abel-msk/RasberryPI-debug-ESP-HAT/BOM.csv

Обозначения | Номинал | Корпус | Кол-во | DNP | Описание
C1,C3 | 100n | Capacitor_SMD:C_0805_2012Metric_Pad1.18x1.45mm_HandSolder | 2 |  | Unpolarized capacitor, small symbol
C2 | 10u | Capacitor_SMD:C_0805_2012Metric_Pad1.18x1.45mm_HandSolder | 1
D1 | GREEN | LED_SMD:LED_0603_1608Metric_Pad1.05x0.95mm_HandSolder | 1 |  | LED 0603 green, ESP power indicator
D2-D11 | BLUE | LED_SMD:LED_0603_1608Metric | 10 |  | LED 0603 blue TO-1608BC-BF, GPIO activity
J1 | GPIO | Connector_PinSocket_2.54mm:PinSocket_2x20_P2.54mm_Vertical | 1 |  | Generic connector, double row, 02x20, odd/even pin numbering scheme (row 1 odd numbers, row 2 even numbers), script generated (kicad-library-utils/schlib/autogen/connector/)
J2,J3 | KF250-2.54-8P | TerminalBlock_Local:KF250-2.54-8P | 2 |  | Spring terminal block KF250-2.54-8P-1 (LCSC C49173293), ESP left row: IO5..IO10, IO20, IO21 (pin 8 = IO21),Spring terminal block KF250-2.54-8P-1 (LCSC C49173293), ESP right row: IO0..IO4, 3V3, GND, ESP 5V (pin 8)
J4,J5 | PinSocket_1x08_P2.54mm | Connector_PinSocket_2.54mm:PinSocket_1x08_P2.54mm_Vertical | 2 |  | Female pin header 1x8, 2.54 mm, vertical, socket for U2 ESP32-C3 SuperMini; BOM only, part of U2 footprint
JP1 | ID_WP | Connector_PinHeader_2.54mm:PinHeader_1x02_P2.54mm_Vertical | 1 |  | Jumper, 2-pole, open (2-pin header)
Q1 | AO3401A | Package_TO_SOT_SMD:SOT-23 | 1
R1,R2 | 3.9k | Resistor_SMD:R_0805_2012Metric_Pad1.20x1.40mm_HandSolder | 2 |  | Resistor, small symbol
R3-R15,R17,R18 | 1k | Resistor_SMD:R_0805_2012Metric_Pad1.20x1.40mm_HandSolder | 15
R16 | 100k | Resistor_SMD:R_0805_2012Metric_Pad1.20x1.40mm_HandSolder | 1
R19-R28 | 1k | Resistor_SMD:R_0603_1608Metric | 10 |  | LED current limit, 0603
SW1 | RESET (power cycle) | SW_SPST_Omron_B3FS-100xP | 1
SW2 | BOOT | SW_SPST_Omron_B3FS-100xP | 1
U1 | CAT24C256 | Package_SO:SOIC-8_3.9x4.9mm_P1.27mm | 1 |  | 256 kb CMOS Serial EEPROM, DIP-8/SOIC-8/TSSOP-8/DFN-8
U2 | ESP32-C3 Pro Mini | ESP_Debug:ESP32-C3_Pro_mini_socket | 1
