abel-msk/RasberryPI-debug-ESP-HAT/schematic.pdf

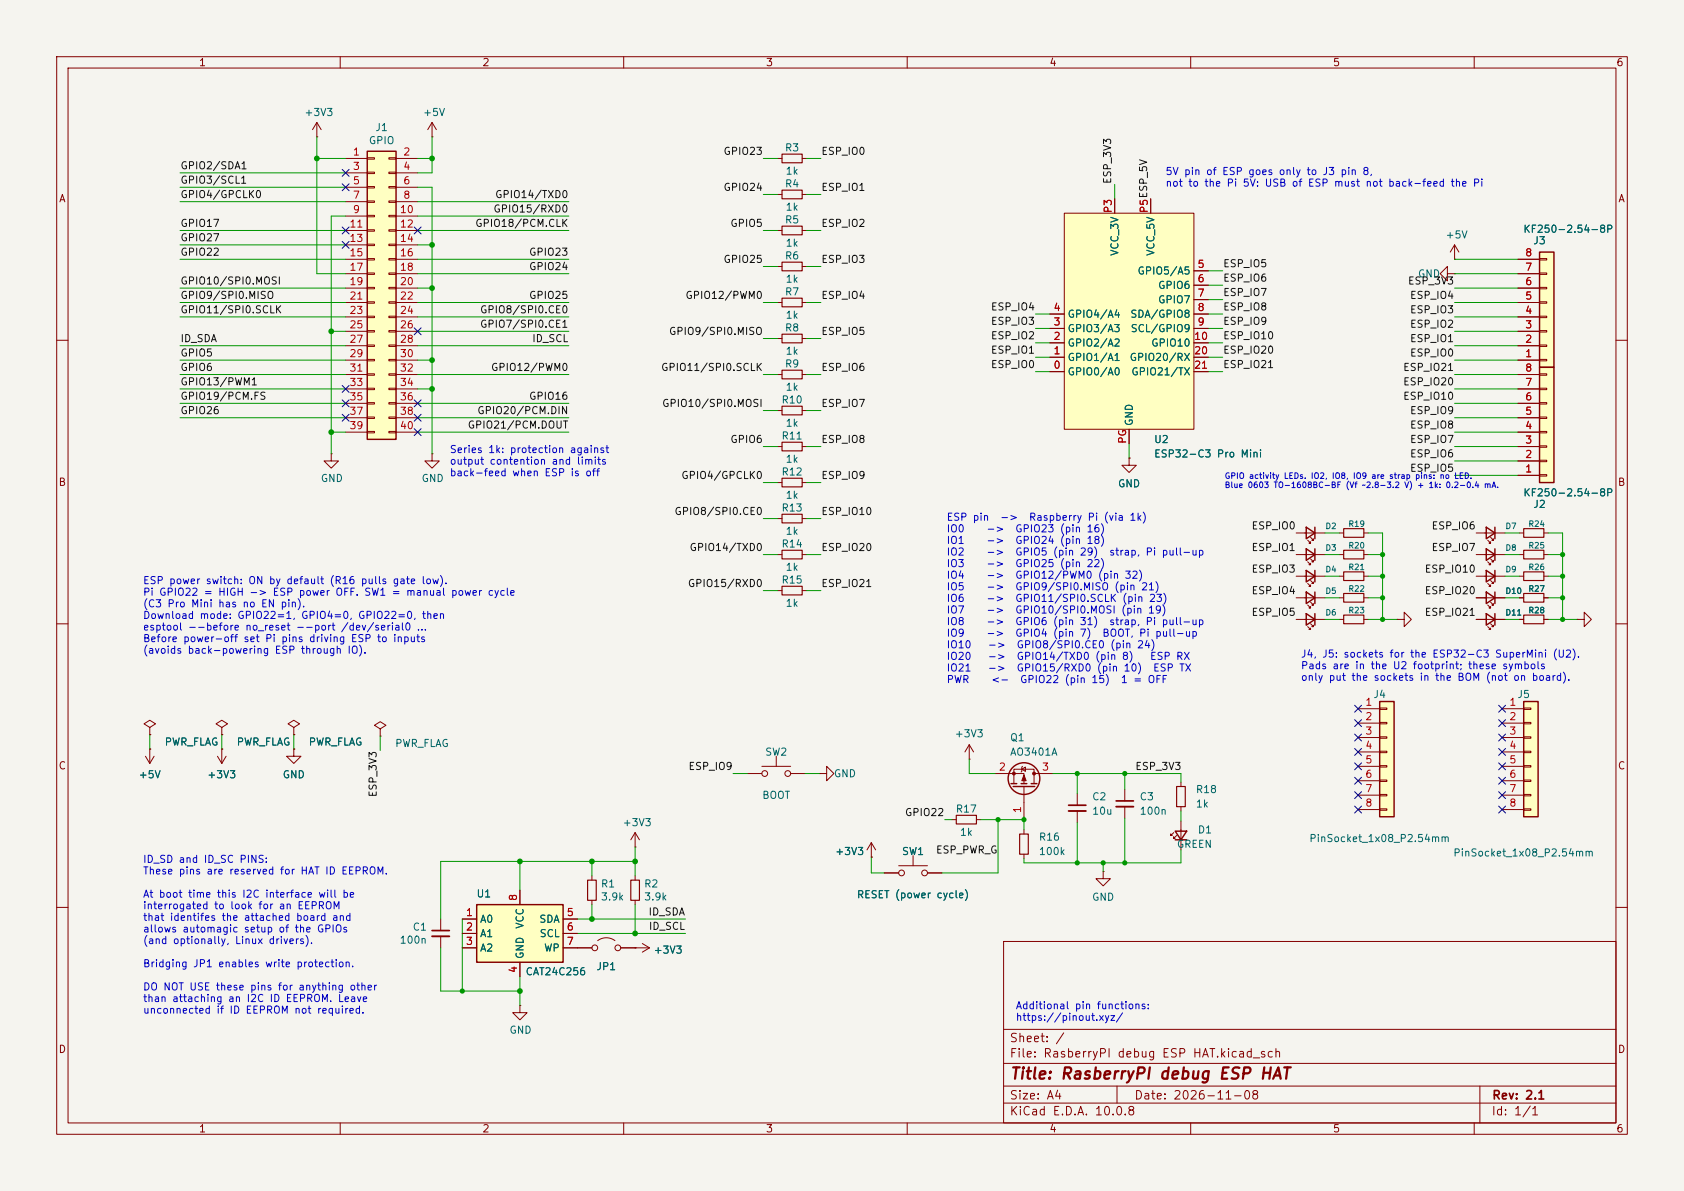
[picture p3: page 1]

GPIO activity LEDs. IO2, IO8, IO9 are strap pins: no LED. Blue 0603 TO-1608BC-BF (Vf ~2.8-3.2 V) + 1k: 0.2-0.4 mA. ESP power switch: ON by default (R16 pulls gate low). Pi GPIO22 = HIGH -> ESP power OFF. SW1 = manual power cycle

ESP pin -> Raspberry Pi (via 1k)

(C3 Pro Mini has no EN pin). Download mode: GPIO22=1, GPIO4=0, GPIO22=0, then

esptool --before no_reset --port /dev/serial0 ... Before power-off set Pi pins driving ESP to inputs

(avoids back-powering ESP through IO).

only put the sockets in the BOM (not on board). Additional pin functions: https://pinout.xyz/

ID_SD and ID_SC PINS: These pins are reserved for HAT ID EEPROM. At boot time this I2C interface will be

interrogated to look for an EEPROM
that identifes the attached board and
allows automagic setup of the GPIOs
(and optionally, Linux drivers).

Bridging JP1 enables write protection. DO NOT USE these pins for anything other

than attaching an I2C ID EEPROM. Leave unconnected if ID EEPROM not required.

Sheet: /
File: RasberryPI debug ESP HAT.kicad_sch
Title: RasberryPI debug ESP HAT

Size: A4 | Rev: 2.1
KiCad E.D.A. 10.0.8 | Id: 1/1
