abel-msk/RasberryPI-debug-ESP-HAT/RasberryPI debug ESP HAT.kicad_pcb

## KiCad design RasberryPI debug ESP HAT.kicad_pcb (2026-11-08)

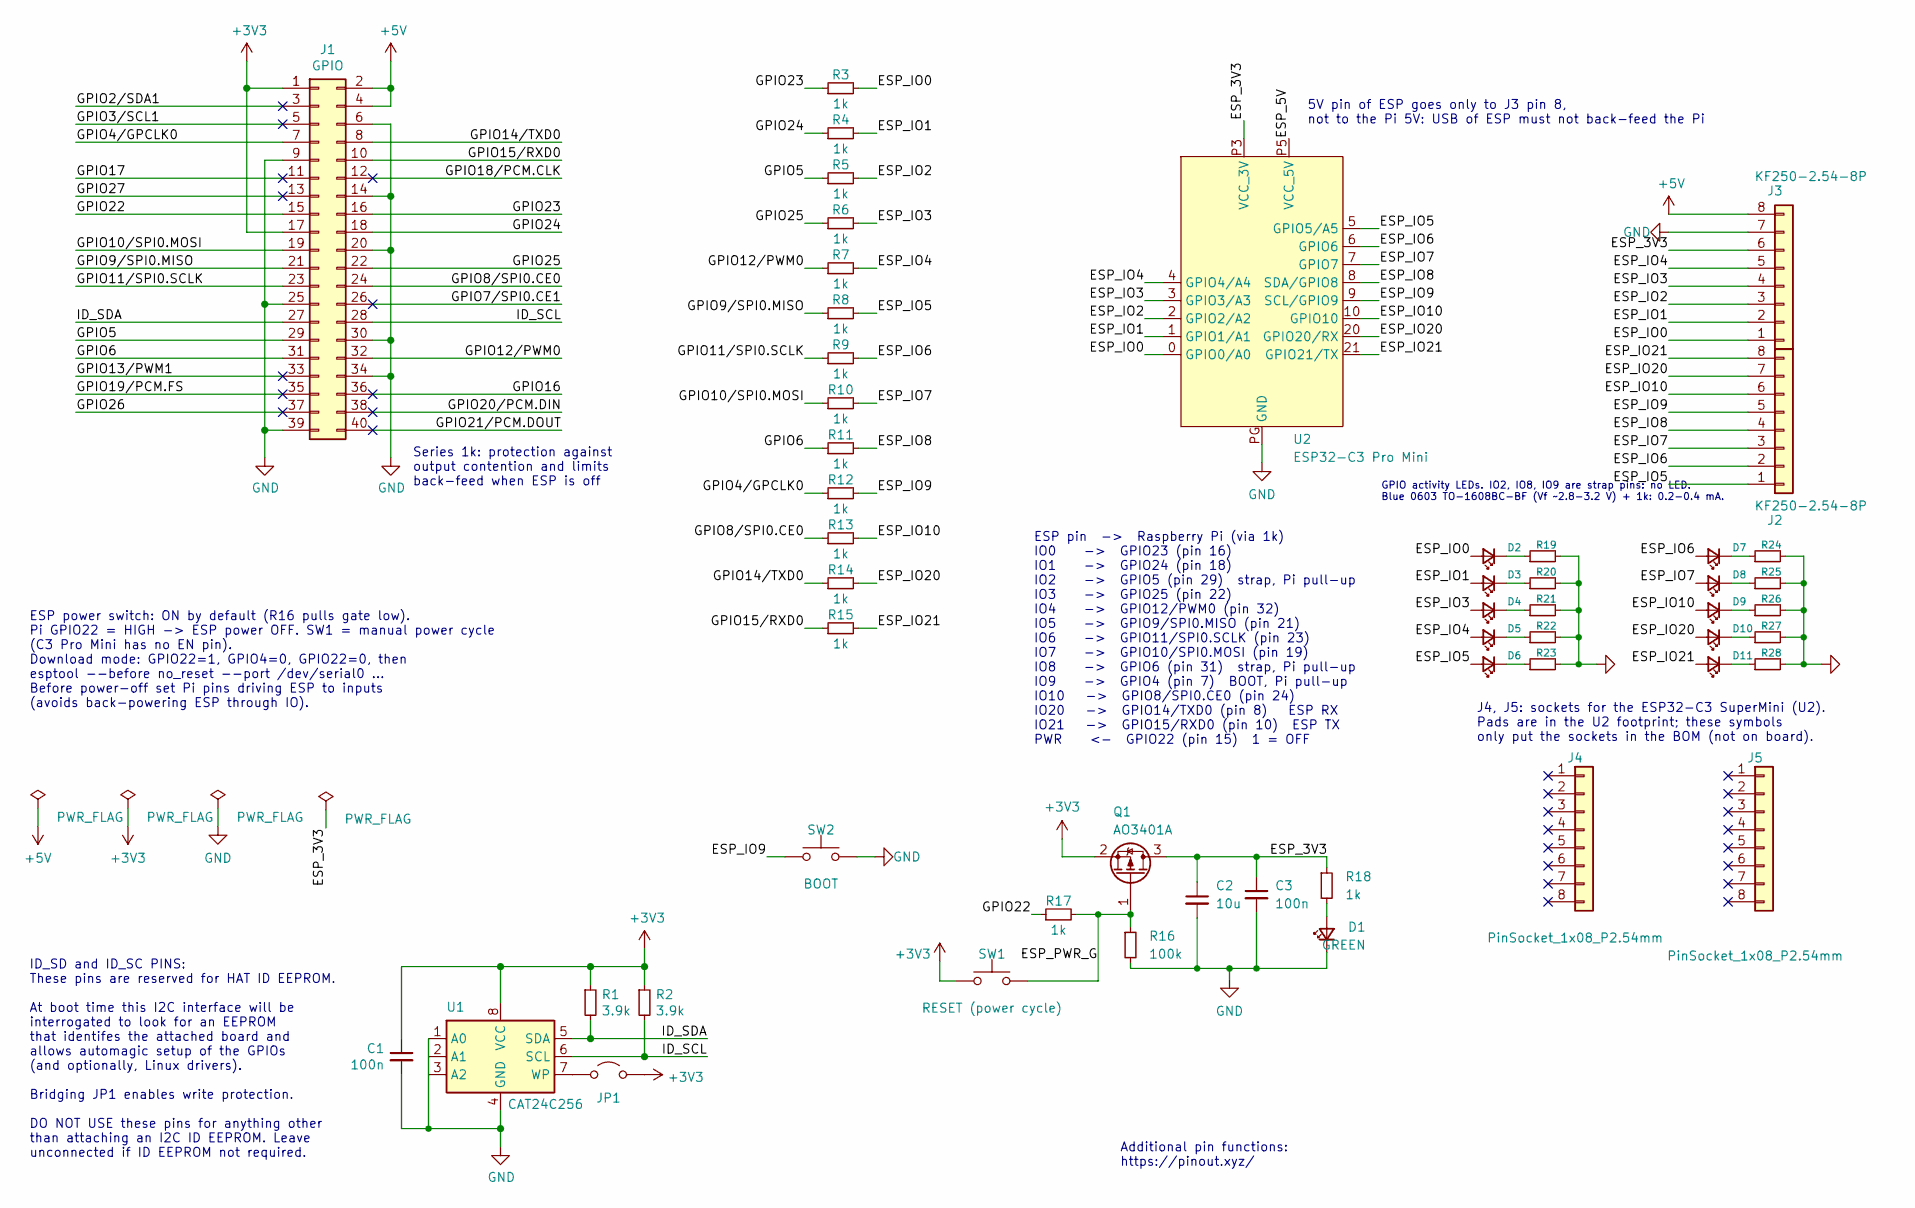
[picture p4: schematic RasberryPI debug ESP HAT.kicad_sch]

Parts:
C1, C3: 100n; C_0805_2012Metric_Pad1.18x1.45mm_HandSolder
C2: 10u; C_0805_2012Metric_Pad1.18x1.45mm_HandSolder
D1: GREEN; LED_0603_1608Metric_Pad1.05x0.95mm_HandSolder
D2, D3, D4, D5, D6, D7, D8, D9, D10, D11: BLUE; LED_0603_1608Metric
J1: GPIO; PinSocket_2x20_P2.54mm_Vertical
J2, J3: KF250-2.54-8P
J4, J5: PinSocket_1x08_P2.54mm; PinSocket_1x08_P2.54mm_Vertical
JP1: ID_WP; PinHeader_1x02_P2.54mm_Vertical
Q1: AO3401A; SOT-23
R1, R2: 3.9k; R_0805_2012Metric_Pad1.20x1.40mm_HandSolder
R3, R4, R5, R6, R7, R8, R9, R10, R11, R12, R13, R14, R15, R17, R18: 1k; R_0805_2012Metric_Pad1.20x1.40mm_HandSolder
R16: 100k; R_0805_2012Metric_Pad1.20x1.40mm_HandSolder
R19, R20, R21, R22, R23, R24, R25, R26, R27, R28: 1k; R_0603_1608Metric
SW1: RESET (power cycle); SW_SPST_Omron_B3FS-100xP
SW2: BOOT; SW_SPST_Omron_B3FS-100xP
U1: CAT24C256; SOIC-8_3.9x4.9mm_P1.27mm
U2: ESP32-C3 Pro Mini; ESP32-C3_Pro_mini_socket

Connections:
+3V3: C1.1, J1.1, J1.17, JP1.2 (B), Q1.2 (S), R1.1, R2.1, SW1.1, U1.8 (VCC)
+5V: J1.2, J1.4, J3.8
/ESP_3V3: C2.1, C3.1, J3.6, Q1.3 (D), R18.1, U2.P3 (VCC_3V)
/ESP_5V: U2.P5 (VCC_5V)
/ESP_IO0: D2.2 (A), J3.1, R3.2, U2.0 (GPIO0/A0)
/ESP_IO1: D3.2 (A), J3.2, R4.2, U2.1 (GPIO1/A1)
/ESP_IO2: J3.3, R5.2, U2.2 (GPIO2/A2)
/ESP_IO3: D4.2 (A), J3.4, R6.2, U2.3 (GPIO3/A3)
/ESP_IO4: D5.2 (A), J3.5, R7.2, U2.4 (GPIO4/A4)
/ESP_IO5: D6.2 (A), J2.1, R8.2, U2.5 (GPIO5/A5)
/ESP_IO6: D7.2 (A), J2.2, R9.2, U2.6 (GPIO6)
/ESP_IO7: D8.2 (A), J2.3, R10.2, U2.7 (GPIO7)
/ESP_IO8: J2.4, R11.2, U2.8 (SDA/GPIO8)
/ESP_IO9: J2.5, R12.2, SW2.1, U2.9 (SCL/GPIO9)
/ESP_IO10: D9.2 (A), J2.6, R13.2, U2.10 (GPIO10)
/ESP_IO20: D10.2 (A), J2.7, R14.2, U2.20 (GPIO20/RX)
/ESP_IO21: D11.2 (A), J2.8, R15.2, U2.21 (GPIO21/TX)
/ESP_PWR_G: Q1.1 (G), R16.1, R17.2, SW1.2
/GPIO2/SDA1: J1.3
/GPIO3/SCL1: J1.5
/GPIO4/GPCLK0: J1.7, R12.1
/GPIO5: J1.29, R5.1
/GPIO6: J1.31, R11.1
/GPIO7/SPI0.CE1: J1.26
/GPIO8/SPI0.CE0: J1.24, R13.1
/GPIO9/SPI0.MISO: J1.21, R8.1
/GPIO10/SPI0.MOSI: J1.19, R10.1
/GPIO11/SPI0.SCLK: J1.23, R9.1
/GPIO12/PWM0: J1.32, R7.1
/GPIO13/PWM1: J1.33
/GPIO14/TXD0: J1.8, R14.1
/GPIO15/RXD0: J1.10, R15.1
/GPIO16: J1.36
/GPIO17: J1.11
/GPIO18/PCM.CLK: J1.12
/GPIO19/PCM.FS: J1.35
/GPIO20/PCM.DIN: J1.38
/GPIO21/PCM.DOUT: J1.40
/GPIO22: J1.15, R17.1
/GPIO23: J1.16, R3.1
/GPIO24: J1.18, R4.1
/GPIO25: J1.22, R6.1
/GPIO26: J1.37
/GPIO27: J1.13
/ID_SCL: J1.28, R2.2, U1.6 (SCL)
/ID_SDA: J1.27, R1.2, U1.5 (SDA)
GND: C1.2, C2.2, C3.2, D1.1 (K), J1.6, J1.9, J1.14, J1.20, J1.25, J1.30, J1.34, J1.39, J3.7, R16.2, R19.2, R20.2, R21.2, R22.2, R23.2, R24.2, R25.2, R26.2, R27.2, R28.2, SW2.2, U1.1 (A0), U1.2 (A1), U1.3 (A2), U1.4 (GND), U2.PG (GND)
unnamed: D1.2 (A), R18.2
unnamed: D2.1 (K), R19.1
unnamed: D3.1 (K), R20.1
unnamed: D4.1 (K), R21.1
unnamed: D5.1 (K), R22.1
unnamed: D6.1 (K), R23.1
unnamed: D7.1 (K), R24.1
unnamed: D8.1 (K), R25.1
unnamed: D9.1 (K), R26.1
unnamed: D10.1 (K), R27.1
unnamed: D11.1 (K), R28.1
unnamed: JP1.1 (A), U1.7 (WP)

Notes on the sheet:
Series 1k: protection against output contention and limits back-feed when ESP is off
J4, J5: sockets for the ESP32-C3 SuperMini (U2). Pads are in the U2 footprint; these symbols only put the sockets in the BOM (not on board).
Additional pin functions: https://pinout.xyz/
ESP pin -> Raspberry Pi (via 1k) IO0 -> GPIO23 (pin 16) IO1 -> GPIO24 (pin 18) IO2 -> GPIO5 (pin 29) strap, Pi pull-up IO3 -> GPIO25 (pin 22) IO4 -> GPIO12/PWM0 (pin 32) IO5 -> GPIO9/SPI0.MISO (pin 21) IO6 -> GPIO11/SPI0.SCLK (pin 23) IO7 -> GPIO10/SPI0.MOSI (pin 19) IO8 -> GPIO6 (pin 31) strap, Pi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
ESP power switch: ON by default (R16 pulls gate low). Pi GPIO22 = HIGH -> ESP power OFF. SW1 = manual power cycle (C3 Pro Mini has no EN pin). Download mode: GPIO22=1, GPIO4=0, GPIO22=0, then esptool --before no_reset --port /dev/serial0 ... Before power-off set Pi pins driving ESP to inputs (avoid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
5V pin of ESP goes only to J3 pin 8, not to the Pi 5V: USB of ESP must not back-feed the Pi
GPIO activity LEDs. IO2, IO8, IO9 are strap pins: no LED. Blue 0603 TO-1608BC-BF (Vf ~2.8-3.2 V) + 1k: 0.2-0.4 mA.
ID_SD and ID_SC PINS: These pins are reserved for HAT ID EEPROM. At boot time this I2C interface will be interrogated to look for an EEPROM that identifes the attached board and allows automagic setup of the GPIOs (and optionally, Linux drivers). Bridging JP1 enables write protection. DO NOT USE th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

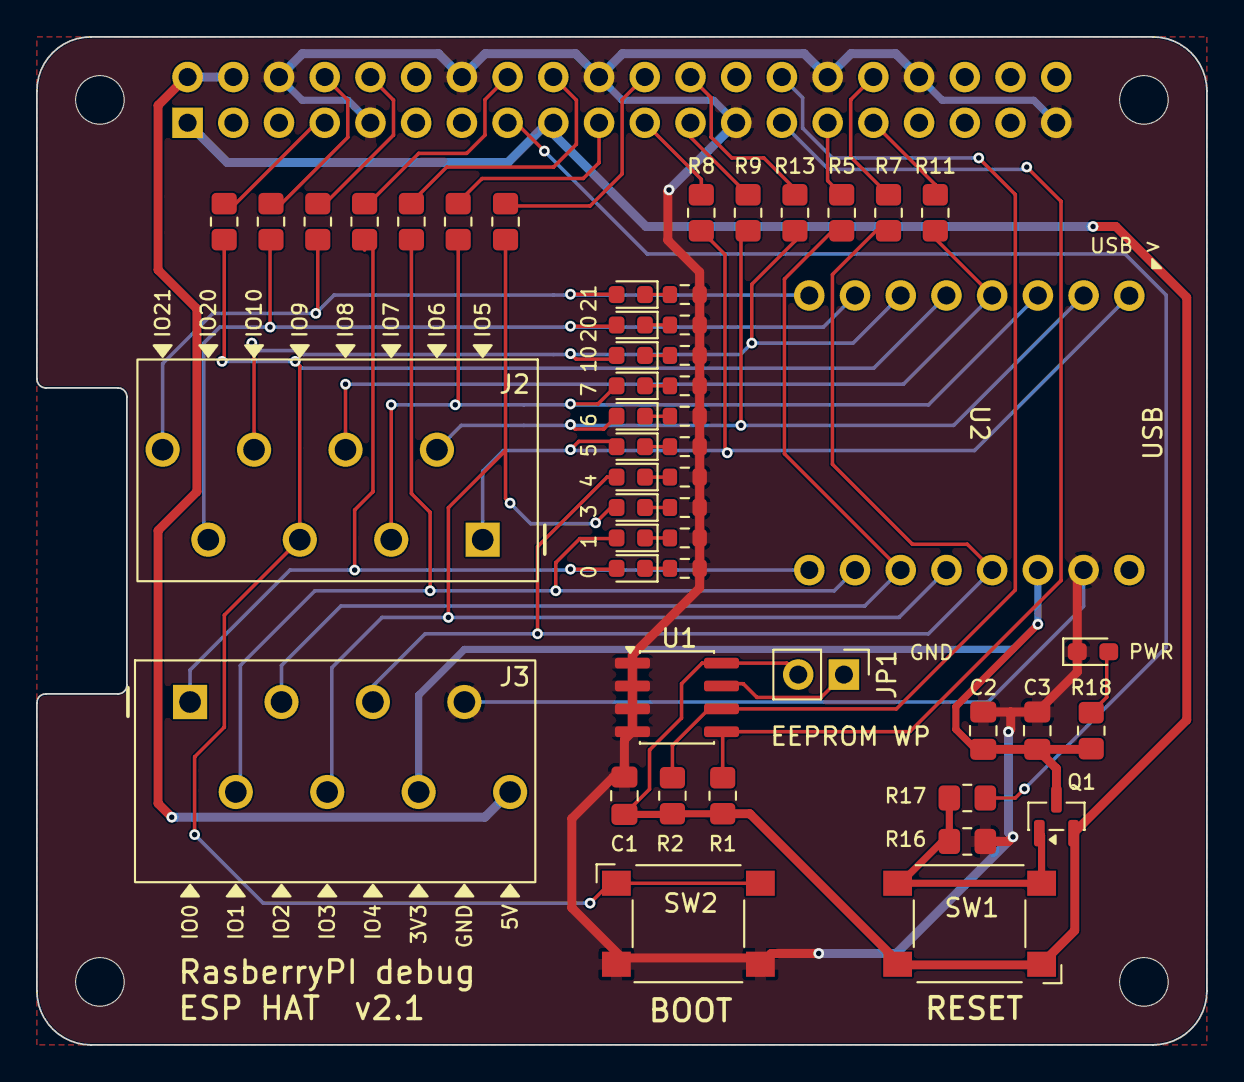
[picture p5: board RasberryPI debug ESP HAT.kicad_pcb from above]

Board: 2 copper layers, 65.0 x 56.0 mm, 55 parts (1 on the bottom side), 46 nets.

Other parts of the board:
MH1, MH2, MH3, MH4: MountingHole_2.7mm_M2.5
