abel-msk/RasberryPI-debug-ESP-HAT/(commit log)

2026-11-06 Initial commit: RasberryPI debug ESP HAT
    KiCad 10 project: Raspberry Pi HAT for debugging an ESP32-C3 Pro Mini
    (65x56 mm, 2 layers). Includes schematic, board, project footprint
    library, and BOM.
    [BOM.csv, RasberryPI debug ESP HAT.kicad_pcb, RasberryPI debug ESP HAT.kicad_sch]
2026-11-07 Replace 16-pin logic analyzer header with two KF243-5.0 terminal blocks
    - J2 (1x16 2.54mm) -> J2 + J3, 8-pin 5.0mm screw terminal blocks
    (footprint: MaiXu MX126-5.0-08P as stand-in for KF243-5.0).
    J2: GND, 3V3, IO21, IO20, IO10, IO9, IO8, IO7; J3: IO6..IO0, GND.
    - Blocks placed in two rows at the bottom edge: J2 wires face up,
    J3 wires face the board edge. Pin labels on silkscreen between rows.
    - Removed the camera FPC slot to make room; SW2 (BOOT) moved to center.
    - Removed tracks left dangling by the old J2; signal routing to the new
    blocks is left as ratsnest for manual routing.
    - BOM regenerated.
    [BOM.csv, RasberryPI debug ESP HAT.kicad_pcb, RasberryPI debug ESP HAT.kicad_sch]
2026-11-07 Use KF243-5.0 spring terminal blocks in two vertical rows
    - New footprints ESP_Debug:KF243-5.0-8P / -7P from the KEFA drawing:
    two pins per pole (rows 5.0 mm apart), 1.3 mm holes, body P*5+2.8 x
    15.1 mm, wire entry marked on silkscreen; 3D from the GrabCAD STEP
    (4P/3P models combined, kept local, not committed).
    - J2 = 8P (GND, 3V3, IO21, IO20, IO10, IO9, IO8, IO7), wires toward the
    ESP module; J3 = 7P (IO6..IO0), wires toward the left edge. Blocks
    stand back to back on the left half. Second GND contact dropped.
    - U1, R1, R2, C1 moved under the ESP module (between its pin rows);
    JP1 and SW2 moved to the bottom centre. Display FPC slot removed.
    - Pin names on back silkscreen; titl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
    [BOM.csv, RasberryPI debug ESP HAT.kicad_pcb, RasberryPI debug ESP HAT.kicad_sch]
2026-11-07 Use KF243 footprints from the shared TerminalBlock_Local library
    J2/J3 now reference TerminalBlock_Local:KF243-5.0-8P / -7P, and their 3D
    models come from ${KIKAD_USER_3DMODELS}/Connectors/Spring_Terminal/KF243.
    Project-local copies in ESP_Debug.pretty removed.
    [RasberryPI debug ESP HAT.kicad_pcb, RasberryPI debug ESP HAT.kicad_sch]
2026-11-07 Replace KF243-5.0 blocks with KF250-2.54 spring terminals (J2 8P, J3 7P)
    Compact back-to-back blocks on the left edge, footprints from the shared
    TerminalBlock_Local library, pin labels on bottom silkscreen, BOM updated.
    [BOM.csv, RasberryPI debug ESP HAT.kicad_pcb, RasberryPI debug ESP HAT.kicad_sch]
2026-11-07 Use two KF250-2.54-8P blocks (J3 pin 8 unused)
    Keep the horizontal back-to-back placement, regenerate bottom-silk pin
    labels for both blocks, BOM updated.
    [BOM.csv, RasberryPI debug ESP HAT.kicad_pcb, RasberryPI debug ESP HAT.kicad_sch]
2026-11-07 Use GrabCAD STEP model (type AB) for KF250-2.54-8P blocks
    [RasberryPI debug ESP HAT.kicad_pcb]
2026-11-07 Restore the display cable notch on the left board edge
    [RasberryPI debug ESP HAT.kicad_pcb]
2026-11-07 Use the detailed colored ESP32-C3 SuperMini 3D model for U2
    The new STEP (Modules/ESP32-C3_SuperMini_detailed.step) is Y-up, so it is
    rotated -90 deg about X and offset to line its castellations up with the
    footprint pads. Updated in both the board and the project footprint library.
    [RasberryPI debug ESP HAT.kicad_pcb]
2026-11-07 Show two 1x08 female pin sockets for U2 instead of the ESP board
    The ESP32-C3 SuperMini plugs into sockets, so the footprint 3D view now uses
    the standard PinSocket_1x08_P2.54mm_Vertical model on each pad row.
    [RasberryPI debug ESP HAT.kicad_pcb]
2026-11-07 Add J4/J5 1x08 female sockets for the ESP board to the BOM
    The pads already live in the U2 footprint, so both symbols are excluded from
    the board and only list the sockets in the BOM. Pins are marked no-connect.
    [BOM.csv, RasberryPI debug ESP HAT.kicad_sch]
2026-11-07 Reorder J2/J3 to follow the ESP32-C3 SuperMini pin rows
    J2 now carries the ESP right row in order (GND, 3V3, IO4..IO0, pin 8 NC for
    5V) and J3 the left row (IO5..IO10, IO20, IO21). Schematic labels, pad nets,
    pin silk labels and descriptions updated. Also includes the schematic layout
    tidy-up and pin functions synced from the editor.
    [BOM.csv, RasberryPI debug ESP HAT.kicad_pcb, RasberryPI debug ESP HAT.kicad_sch]
2026-11-07 Map J2 to the ESP left row and J3 to the right row
    J2 pin 1..8 = ESP IO5, IO6, IO7, IO8, IO9, IO10, IO20, IO21.
    J3 pin 1..8 = ESP IO0, IO1, IO2, IO3, IO4, 3V3, GND, 5V.
    The ESP 5V pin now goes to J3 pin 8 only (net ESP_5V), still isolated from
    the Pi 5V rail. Schematic, pad nets, pin silk labels and BOM updated.
    [BOM.csv, RasberryPI debug ESP HAT.kicad_pcb, RasberryPI debug ESP HAT.kicad_sch]
2026-11-07 Add front silkscreen pin labels for J2/J3; include layout edits
    Labels sit at the wire-entry side of each KF250 block, one per pin.
    Also commits the current routing/placement and schematic layout edits.
    [RasberryPI debug ESP HAT.kicad_pcb, RasberryPI debug ESP HAT.kicad_sch]
2026-11-07 Move J3 bottom pin labels between the pad rows
    [RasberryPI debug ESP HAT.kicad_pcb]
2026-11-07 Silkscreen text sizes and schematic tweaks (user edits)
    [RasberryPI debug ESP HAT.kicad_pcb, RasberryPI debug ESP HAT.kicad_sch]
2026-11-07 Add README with 3D render (ESP plugged into the socket); refresh BOM and PDF
    [BOM.csv]
2026-11-07 README renders: ESP seated on the sockets, no protruding header pins
2026-11-07 Add GPIO activity LEDs for ESP lines
    D2-D11 with R19-R28 on IO0, IO1, IO3-IO7, IO10, IO20, IO21
    (line -> LED -> resistor -> GND). Strap pins IO2, IO8, IO9 have none.
    Red 0603 + 3k, blue 0603 + 470 on UART. Placed as a vertical column
    between the KF250 blocks and the ESP, with IO numbers on F.SilkS.
    Tracks are not routed yet.
    [BOM.csv, RasberryPI debug ESP HAT.kicad_pcb, RasberryPI debug ESP HAT.kicad_sch]
2026-11-07 Unify LED descriptions so the BOM groups cleanly
    [BOM.csv, RasberryPI debug ESP HAT.kicad_pcb, RasberryPI debug ESP HAT.kicad_sch]
2026-11-07 Use green LEDs with 1k for the GPIO activity LEDs
    Pure-green 0603 (Vf ~2.8-3.2 V) + 1k: 0.2-0.4 mA, and a Pi-driven
    line still sits above 2.9 V at the ESP input. Includes the current
    silkscreen/routing edits from the editors.
    [BOM.csv, RasberryPI debug ESP HAT.kicad_pcb, RasberryPI debug ESP HAT.kicad_sch]
2026-11-07 README renders: use the board stackup colours (green mask)
2026-11-08 Board title on the front silkscreen, revision 2.1
    Front: "RasberryPI debug / ESP HAT v2.1" between the terminal blocks.
    Back text, PCB and schematic title blocks set to rev 2.1.
    README: version table.
    [RasberryPI debug ESP HAT.kicad_pcb, RasberryPI debug ESP HAT.kicad_sch]
2026-11-08 Rev 2.1 silkscreen and LED colour updates
    - Board title moved to the bottom left, larger font
    - ESP outline and antenna marking removed from U2 (board and library)
    - "EEPROM WP" label under JP1, "PWR" label next to D1
    - D1 green (ESP power), D2-D11 blue TO-1608BC-BF
    - README: EEPROM/JP1 section, LED colours; renders refreshed
    - Includes the current placement/routing edits from the editors
    [BOM.csv, RasberryPI debug ESP HAT.kicad_pcb, RasberryPI debug ESP HAT.kicad_sch]
2026-11-08 Remove outdated board-render.png (replaced by images/)
